vladkorotnev/cd-player/sch/sub/keypad/keypad.step

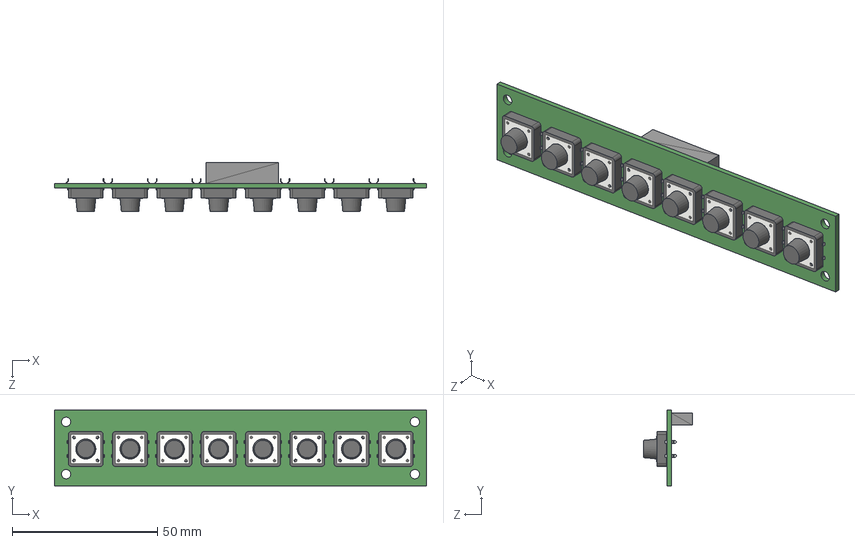
[picture p2: CAD file, 2025-03-11]
sch/sub/keypad/keypad.step
128.0 x 26.0 x 16.7 mm
Board_keypad
12mm_x_12mm_Tactile_switch_Button x 8
09DB-6S(LF)
