vladkorotnev/cd-player/(threads)

Thread 2 (2025-03-13):

Schematic image?

nuxeh, 2025-03-13:
Hi, this is wonderful. But I was thinking that maybe it would be nice for there to be an image showing the schematic in this repo somewhere, for documentation purposes, to get a quick idea of the overview, without having to have the correct EDA software available. Thanks!

vladkorotnev, 2025-03-14:
Good call, I've added [a PDF](https://github.com/vladkorotnev/cd-player/blob/master/sch/sch.pdf)

Be wary of the [errata](https://github.com/vladkorotnev/cd-player/blob/master/sch/errata.md) before putting anything together according to the schematic. For now it's fixed on my "local" PCBs with bodge wires :P

Closed 2025-03-14.

Thread 3 (2025-04-11):

Webradio ESP32

Raima010, 2025-04-11:
Hi Vlad. Its is not actually an issue but questions about your Cd  player project. You have modified a little bit Pschatzmann´s code which has some issues with internet radio stream buffering and got better results as I understood.
My question is would it be difficult to integrade just your web radio part in a simple Arduino ide sketch as example to test the perforrmance.  You use quite deep intergration with the rest of your project so its a little bit tricky to extract only what is needed? Can you give some tips on that or eventually down strip code limited just to Web radio-bluetooth receiver?
Simple arduino sketch for webradio which is given by Pschatzmann looks like this:

#include "Arduino.h"
#include "WiFi.h"
#include "Audio.h"
// Connections ESP32 <-> Amplifier
#define I2S_DOUT  2
#define I2S_BCLK  3
#define I2S_LRC   4
Audio audio;
// Wifi Credentials
String ssid =    "YOUR NETWORK";
String password = "YOUR PASSWORD";

void setup() {

  Serial.begin(115200);
  WiFi.disconnect();
  WiFi.mode(WIFI_STA);
  WiFi.begin(ssid.c_str(), password.c_str());
  while (WiFi.status() != WL_CONNECTED) {
    delay(500);
    Serial.print(".");
  }

  audio.setPinout(I2S_BCLK, I2S_LRC, I2S_DOUT);
  // Volume (0-100)
  audio.setVolume(10);
  // Radio stream, e.g. Byte.fm
  audio.connecttohost("http://www.byte.fm/stream/bytefm.m3u");

}

void loop()

{
  audio.loop();

}

We take in consideration that one would use ESP32 module with PSRAM.

Thank you for your comments.

vladkorotnev, 2025-04-11:
The whole radio pipeline is basically located in a [separate file](https://github.com/vladkorotnev/cd-player/blob/master/firm/src/mode/netradio/pipeline.h), where the AudioRouter's IOPortNub is your I2SStream in the simplest case. (I plan to potentially add other output routes someday later, so I obtain the output port from the router)

So in the simplest case you would just take that class, change the argument to accept an I2SStream instead of the AudioRouter, then instantiate it and call something like `pipeline.start("www.example.com/radio.mp3", [](bool loading) { if(loading) Serial.println("NOW LOADING!"); });` and there it goes!

I have to note that if you are not buying your ESP modules from a verified source such as Digikey (I was buying off some seller on Taobao), your mileage may vary. I was getting vastly different reliability among ESPs even in the same batch, although none of them worked with Phil's code at all.

Increasing the Net Buffer to e.g. 2KB makes things more stable, but with some lower bitrate radios it takes a very long while for the buffer to fill up.

One good idea would be to make an automatic buffer increase algorithm so that e.g. originally it only buffers to the 10% mark, upon stutter now it uses 20%, and so on... (please do a PR if you implement this :-)

Be that as it may, this is my daily driver radio now and it works more stable than any other projects I've tried so far (KaRadio and Phil's examples) — but then again, maybe my ESPs or internet are just bad.

Raima010, 2025-04-13:
Well, I made a try, but can not get it working..
Modified class to accept I2S stream:

class StreamingPipeline {
    public:
        StreamingPipeline(I2SStream *i2sStream):
            bufferNetData(NET_DATA_BUFFER_SIZE),
            bufferPcmData(PCM_DATA_BUFFER_SIZE, 1, portMAX_DELAY, portMAX_DELAY, fastAlloc),
            queueNetData(bufferNetData),
            queuePcmData(bufferPcmData),
            activeCodec(nullptr),
            decoder(&queueNetData, activeCodec),
            copierDownloading(queueNetData, urlStream),
            sndTask("IRASND", 8192, 8, 0),
            codecTask("IRADEC", 40000, 6, 1),
            netTask("IRANET", 20000, 14, 1),
            copierDecoding(decoder, queueNetData),
            copierPlaying(*i2sStream, queuePcmData) {
                outPort = i2sStream;
                semaSnd = xSemaphoreCreateBinary();
                semaNet = xSemaphoreCreateBinary();
                semaCodec = xSemaphoreCreateBinary();
                xSemaphoreGive(semaSnd);
                xSemaphoreGive(semaNet);
                xSemaphoreGive(semaCodec);
        }
....
protected:
        AudioStream * outPort;
        //AudioOutput* outPort;

******************************Arduino IDE sketch
#include "AudioTools.h"
#include "pipeline.h"
#include <WiFi.h>

Static I2SStream i2s;

#define I2S_BCLK   26
#define I2S_LRCLK  25
#define I2S_DOUT   22

void setup() {
  Serial.begin(115200);

  I2SConfig config;
  config.sample_rate = 44100;
  config.bits_per_sample = 16;
  config.channels = 1;
  config.pin_bck = I2S_BCLK;
  config.pin_ws = I2S_LRCLK;
  config.pin_data = I2S_DOUT;

  // Initialize I2S and Pipeline
  i2s.begin(config);
  pipeline.start("http://stream.radioparadise.com/mp3-192", [](bool loading) { if(loading) Serial.println("NOW LOADING!"); });
}

void loop() {
   delay(1000);
}
*********************************************************

It compiles, but silently crashes in urlStream.begin(url.c_str());. On the URLStream.h side on "if (!preProcess(urlStr, acceptMime))" where acceptMime gets null pointer. Hardcoding this doesnt help either.

Any Ideas? Or what I am missing here?

vladkorotnev, 2025-04-13:
Please use the code formatting (put ``` on the lines before and after) when pasting code, it's very hard to read otherwise

If anything, I cannot find where is your `pipeline` variable initialized, neither the code that does the WiFi connection and then waits for it to complete (it was there in your original post but not the new one). So maybe the ESP is just not connected to the WiFi which triggers some bug in AudioTools.

Raima010, 2025-04-14:
Sorry I took too much line to be it more readable but it may take in confution. Here is 100% sketch:

put``

#include "AudioTools.h"
#include "pipeline.h"
#include <WiFi.h>

const char* ssid = "mySSID";
const char* pasword = "myPassword";

static I2SStream i2s;

#define I2S_BCLK   26
#define I2S_LRCLK  25
#define I2S_DOUT   22

void setup() {
  Serial.begin(115200);

   WiFi.mode(WIFI_STA); //Optional
   WiFi.begin(ssid, pasword);
   Serial.println("\nConnecting");
    while(WiFi.status() != WL_CONNECTED){Serial.print(".");delay(100);}                             
    Serial.println("\nConnected to the WiFi network");
    Serial.print("Local ESP32 IP: ");
    Serial.println(WiFi.localIP());

  // Config object for I2SStream
  I2SConfig config;
  config.sample_rate = 44100;
  config.bits_per_sample = 16;
  config.channels = 1;
  config.pin_bck = I2S_BCLK;
  config.pin_ws = I2S_LRCLK;
  config.pin_data = I2S_DOUT;

  // Initialize I2S and Pipeline
  i2s.begin(config);
  StreamingPipeline pipeline(&i2s);
  pipeline.start("http://stream.radioparadise.com/mp3-192", [](bool loading) { if(loading) Serial.println("NOW LOADING!"); });
}

void loop() {
   delay(1000);

}  ``

So we get on Serial that wifi is connected. Get into pipeline.h code, and rigt in the function url.begin(url.c_str() it hangs. There it calls URLStream.h from audiotools and stops with preprocessor with acceptMime nullptr. No more output on Serial, no ESP WDT reboot, nothing more. Wondering if can be some memory issues, core issues or still error in code..
Hardware on I2S with simple sine generator code tested and working.

vladkorotnev, 2025-04-14:
You are declaring the StreamingPipeline variable inside of the setup method. So when the `pipeline.start()` method returns, the setup method ends, and the pipeline variable is deleted, releasing all underlying resources. However the threads started by the pipeline still live on, so if you're lucky you get a crash with a stack trace, otherwise the ESP continues to execute some random place in memory or hangs waiting on some semaphore/spinlock.

Make the pipeline variable static and put it outside of the setup method (e.g. right on the next line after your I2SStream) and it should behave correctly

Closed 2025-04-14.
