vladkorotnev/cd-player/sch/sch.pdf

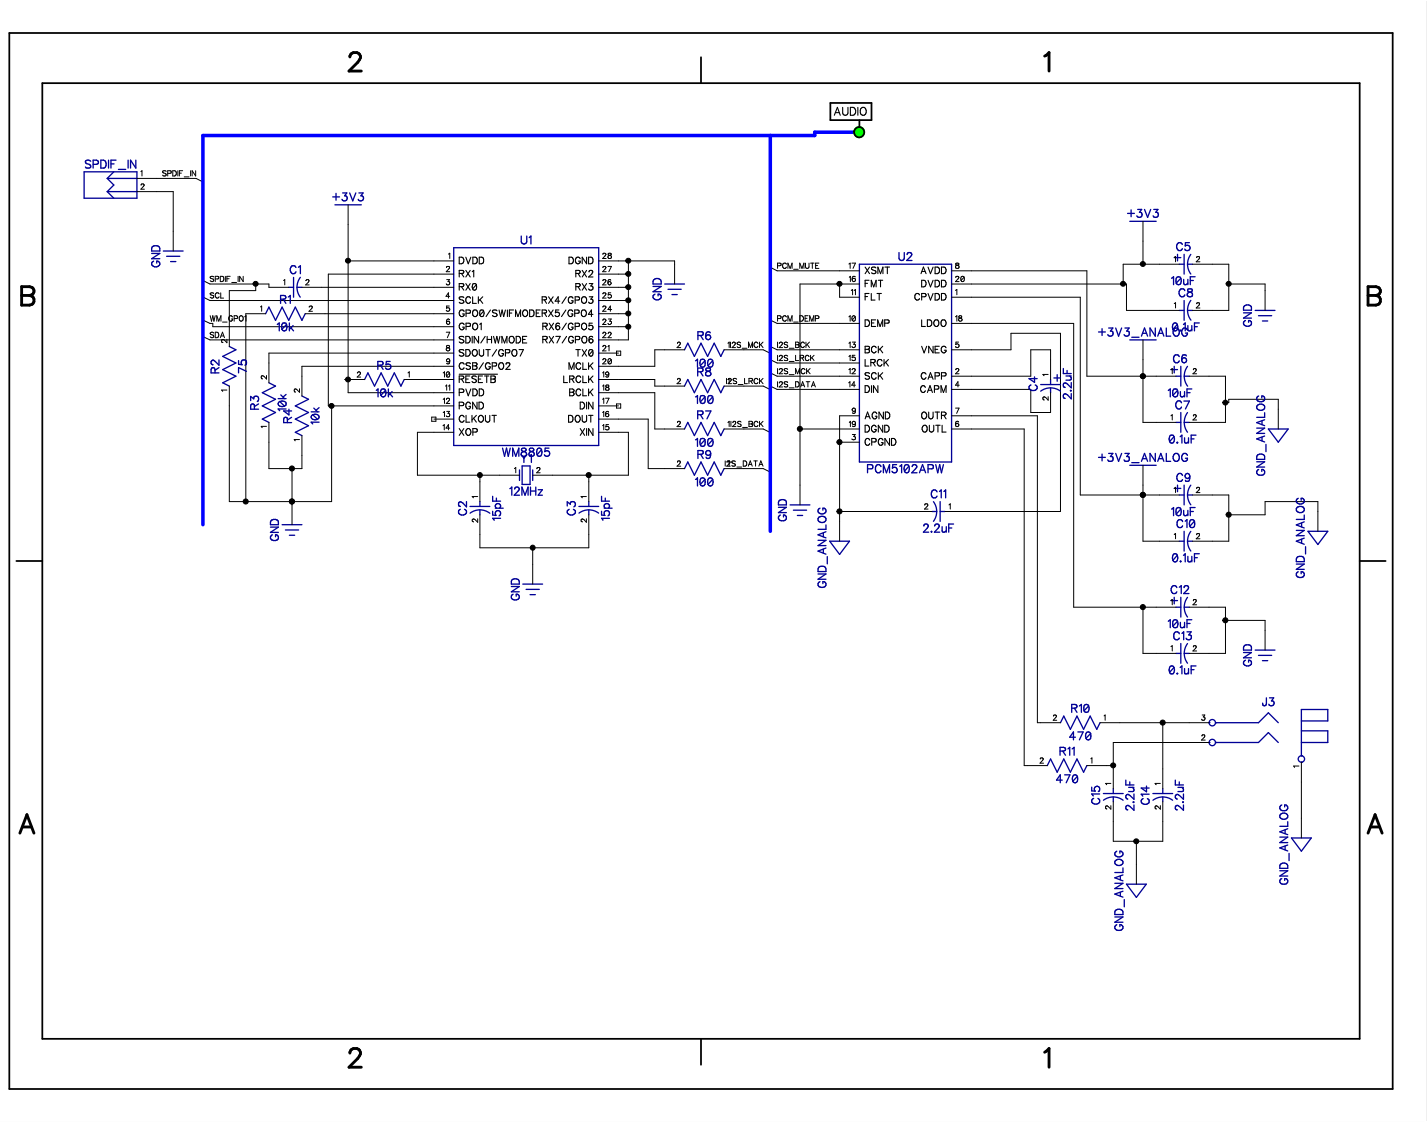
[picture p3: page 1]

DGND 19 | 6

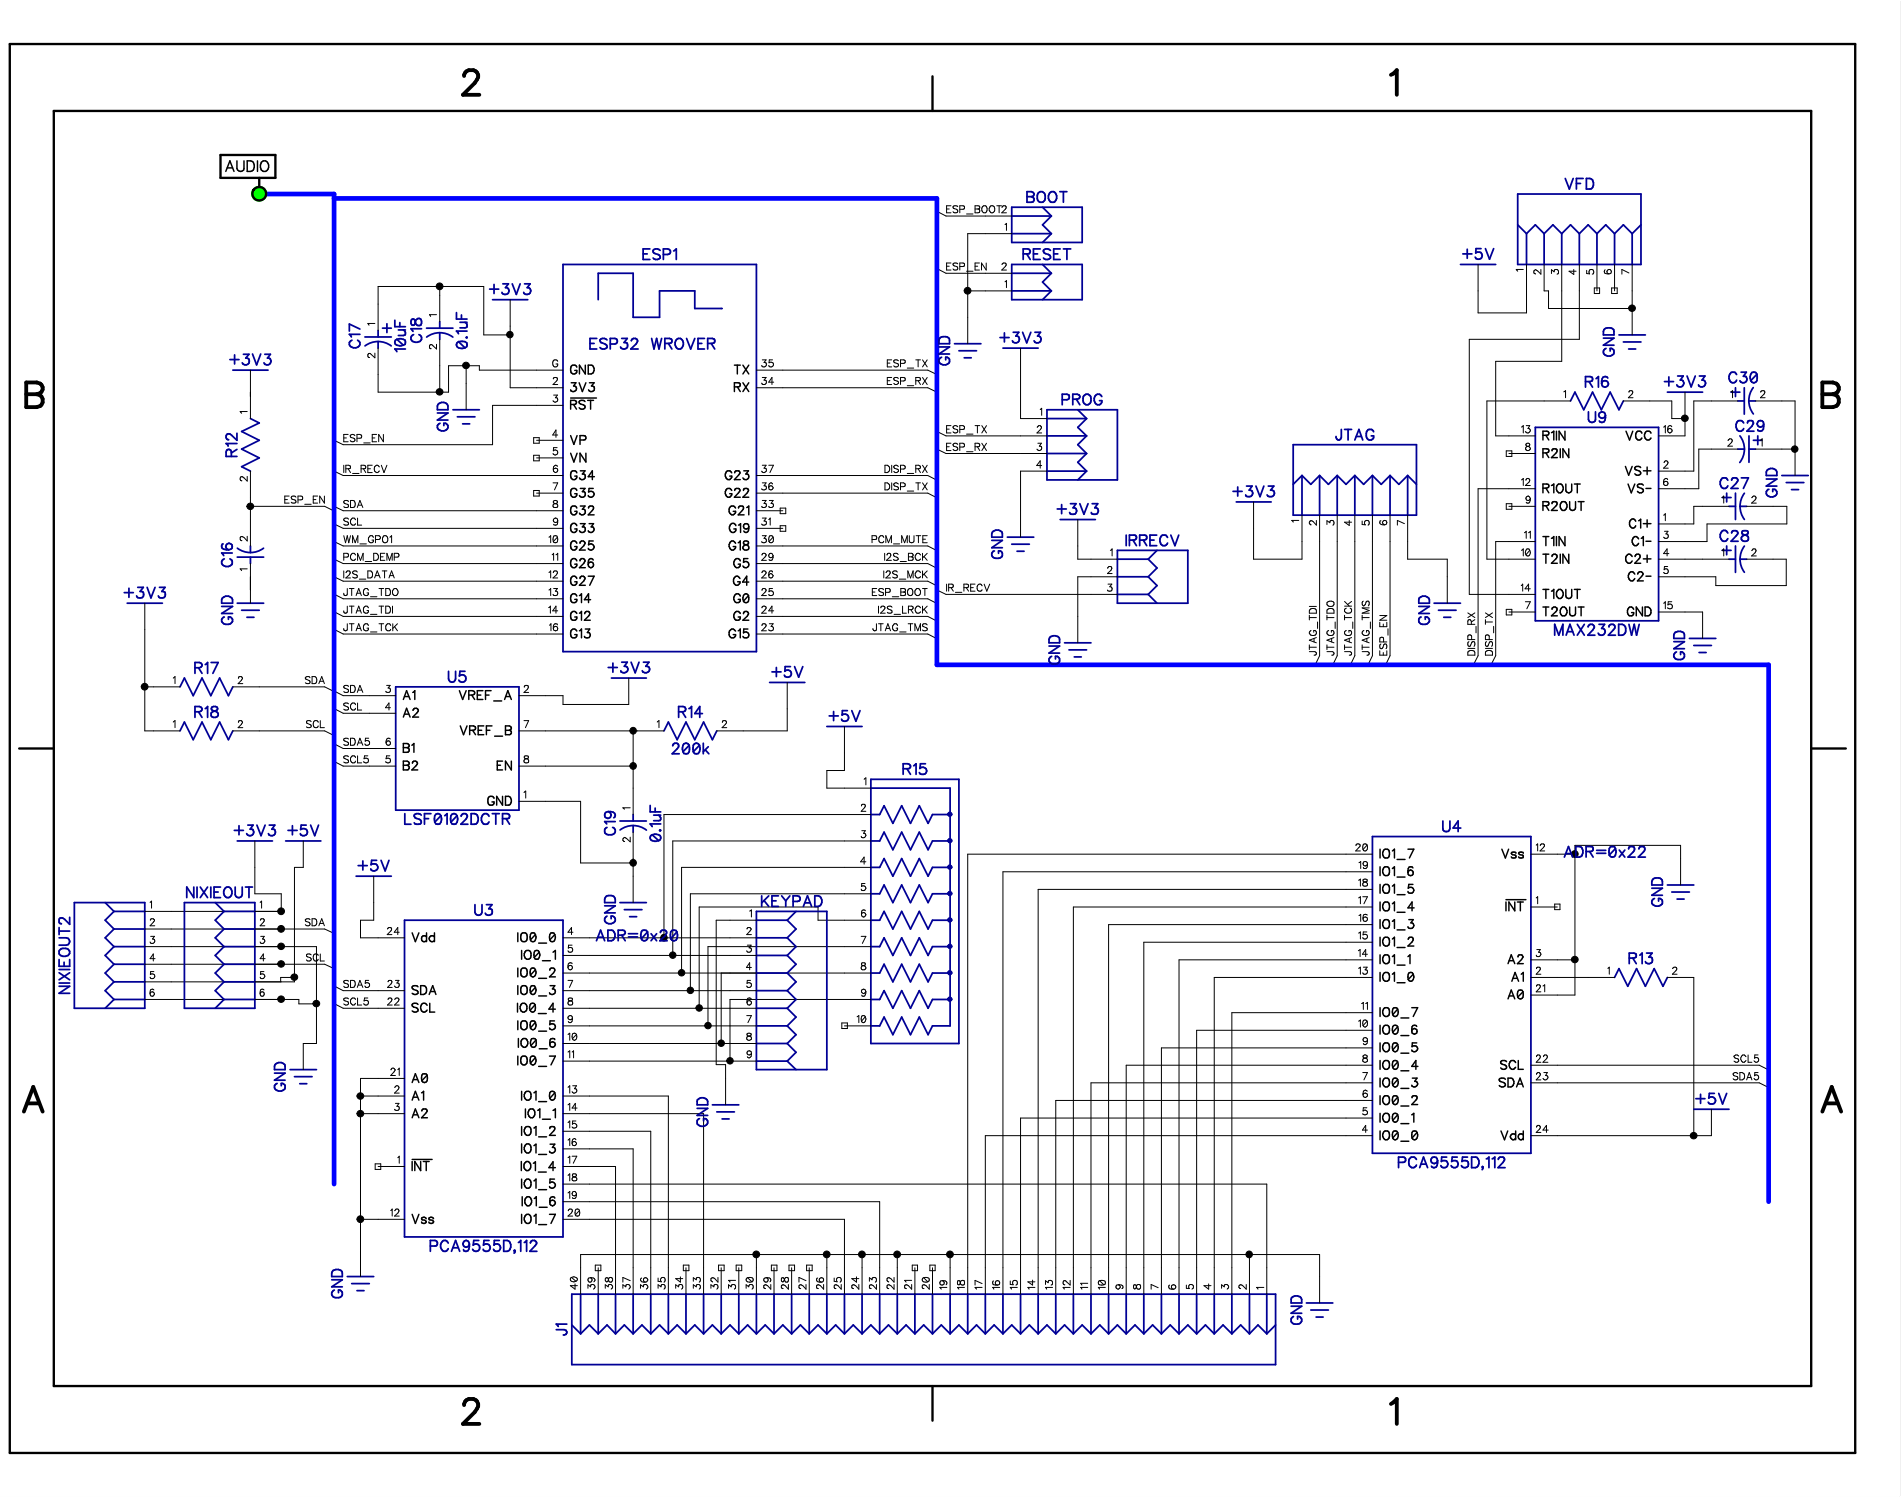
[picture p4: page 2]

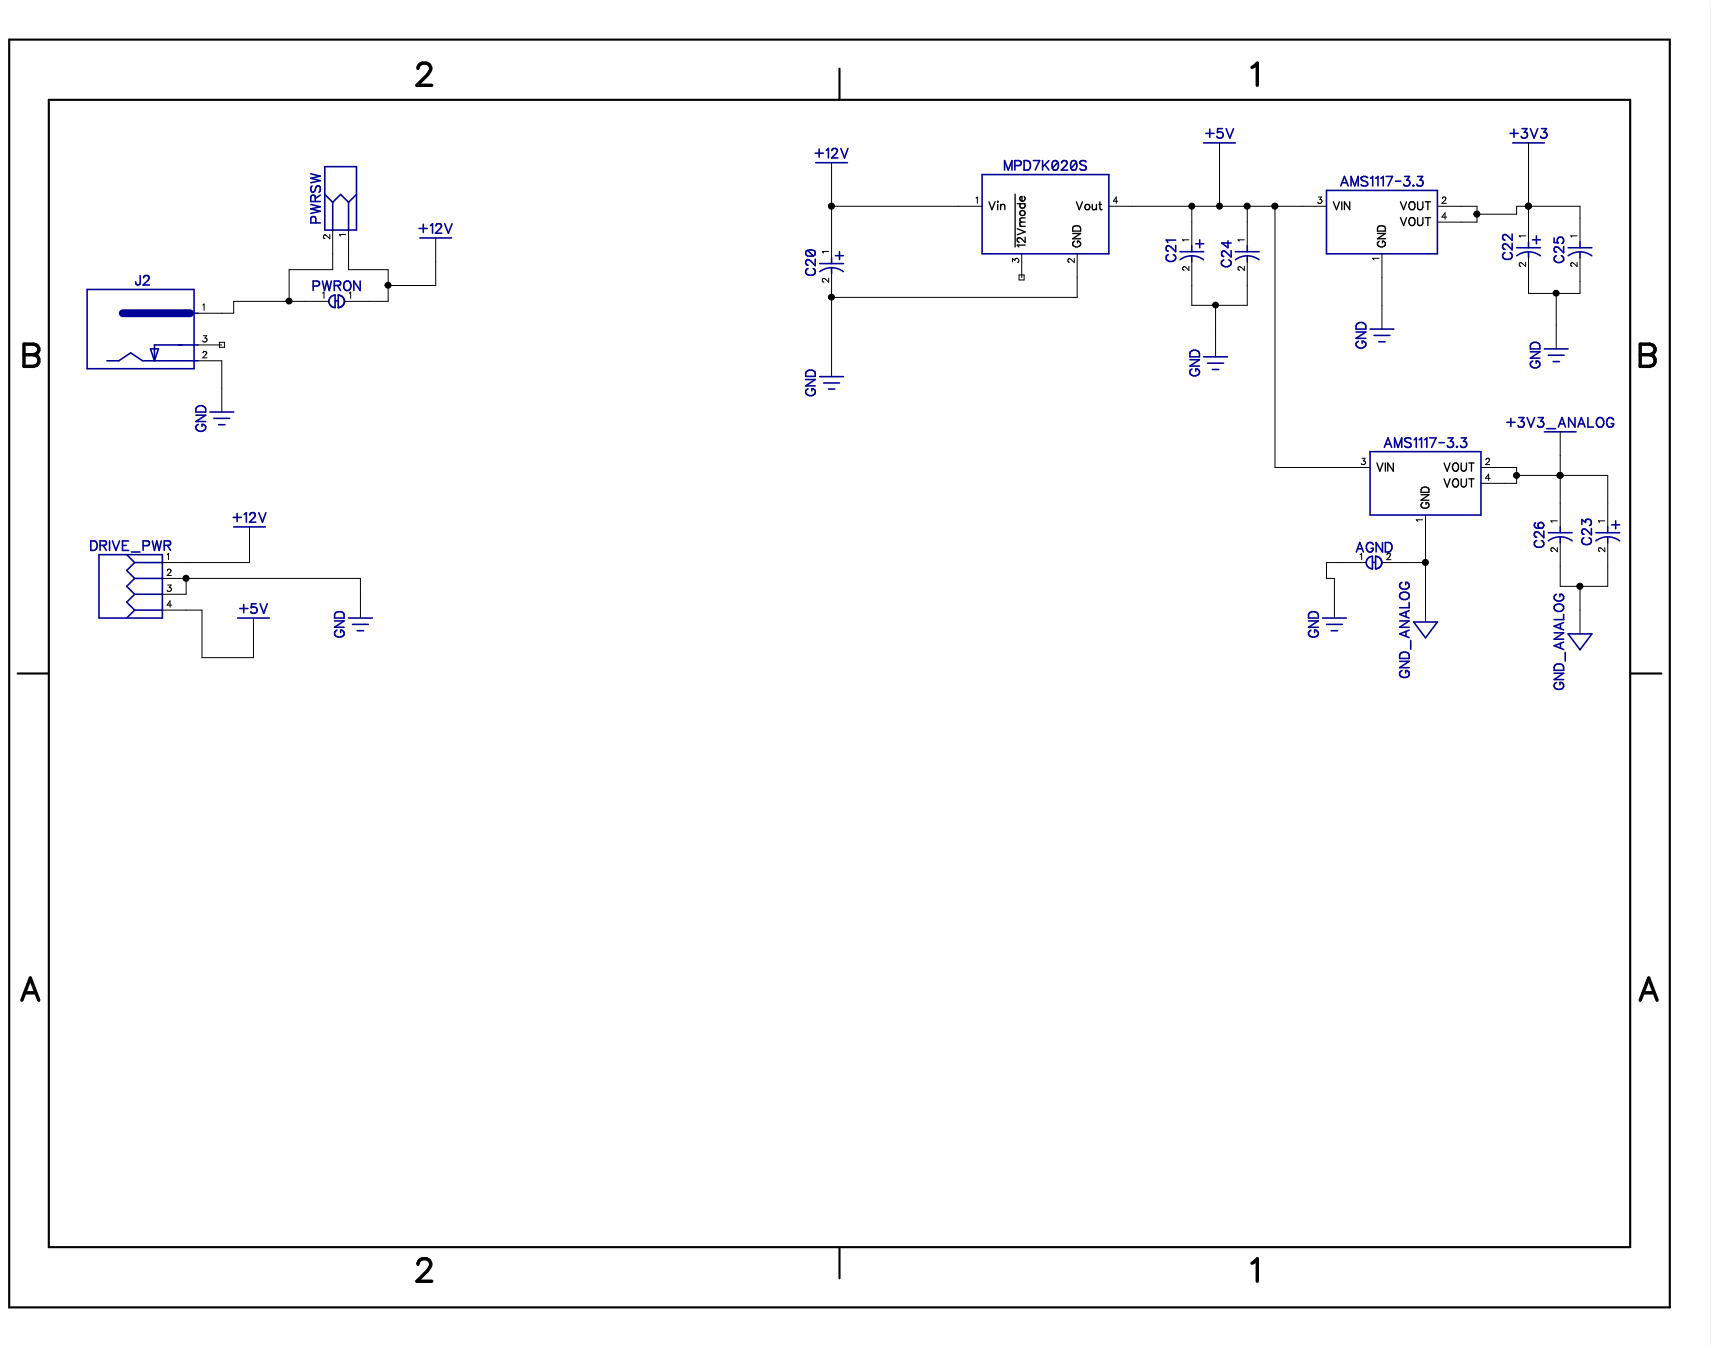
[picture p5: page 3]
