vladkorotnev/cd-player/sch/sub/keypad/keypad.pdf

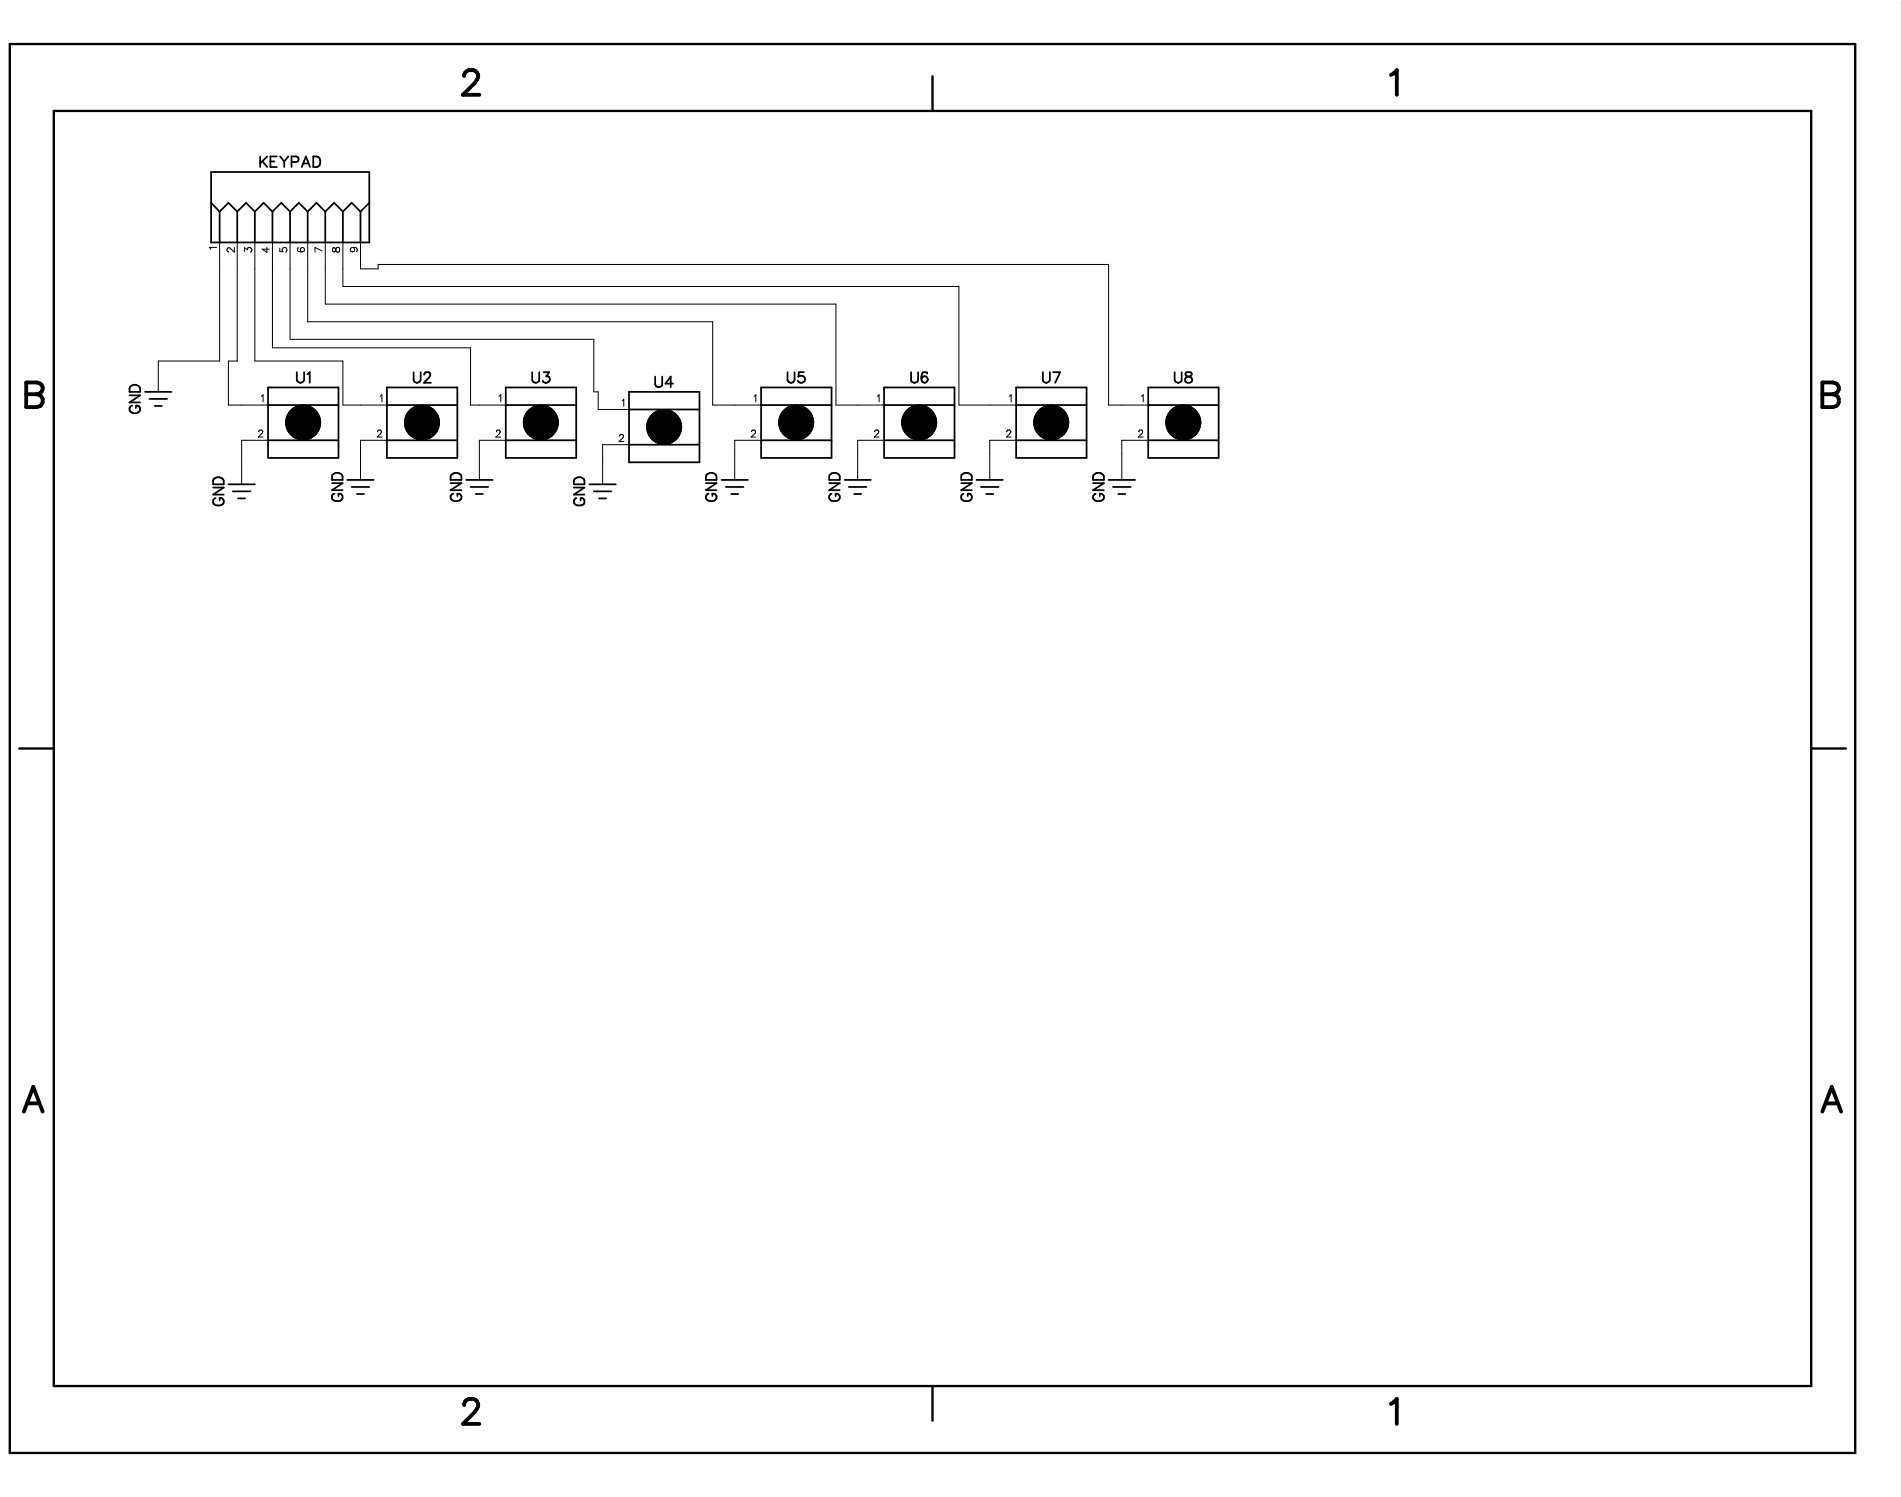
[picture p6: page 1]
