vladkorotnev/cd-player/(list of files, drawings)

Other design files:
sch/cdp.dip
sch/sch.dch
sch/sub/keypad/keypad.dch
sch/sub/keypad/keypad.dip
