vladkorotnev/cd-player/firm/src/localize.cpp

#include <localize.h>
#include <esp_attr.h>
#include <map>
#include <esper-core/prefs.h>
#include <ArduinoJson.h>
#include <LittleFS.h>
#include <shared_prefs.h>

#ifndef LANG_DIR_PREFIX
#define LANG_DIR_PREFIX "/lang"
#endif

static const char LOG_TAG[] = "LOCA";

DisplayLanguage active_language() {
    return (DisplayLanguage) Prefs::get(PREFS_KEY_UI_LANGUAGE);
}

void set_active_language(DisplayLanguage lang) {
    Prefs::set(PREFS_KEY_UI_LANGUAGE, (int)lang);
}

const std::string language_name(DisplayLanguage lang) {
    switch(lang) {
        case DSPL_LANG_RU: return "Русский";
        case DSPL_LANG_JA: return "日本語";
        case DSPL_LANG_EN: return "English";
        default:
            return "???";
    }
}

static DisplayLanguage lang_map_language = DSPL_LANG_INVALID;
static EXT_RAM_ATTR std::map<const std::string, std::string> lang_map = {};

static bool _load_lang_map_if_needed() {
    DisplayLanguage lang =  active_language();
    if(lang_map_language == lang) return true;

    lang_map.clear(); // otherwise switching to "implicit"/native locale fails

    const char * filename = nullptr;
    switch(lang) {
        case DSPL_LANG_RU:
            filename = LANG_DIR_PREFIX "/ru.lang";
            break;
        case DSPL_LANG_JA:
            filename = LANG_DIR_PREFIX "/ja.lang";
            break;
        case DSPL_LANG_EN:
        default:
            filename = LANG_DIR_PREFIX "/en.lang";
            break;
    }

    File f = LittleFS.open(filename, "r");
    if(!f) {
        ESP_LOGE(LOG_TAG, "Loading %s failed! No such file? Pretending nothing happened.", filename);
        lang_map_language = lang;
        return false;
    }

    JsonDocument content;
    DeserializationError error = deserializeJson(content, f);
    if(error) {
        ESP_LOGE(LOG_TAG, "Parsing %s failed: %s", filename, error.c_str());
        lang_map_language = lang;
        return false;
    }

    JsonObject root = content.as<JsonObject>();
    int i = 0;

    for (JsonPair kv : root) {
        std::string val = kv.value().as<std::string>();
        lang_map[kv.key().c_str()] = val;
        i++;
    }

    lang_map_language = lang;
    ESP_LOGI(LOG_TAG, "Loaded language ID=%i, Entries: %i", lang_map_language, i);
    return true;
}

const std::string localized_string(const std::string& key) {
    if(!_load_lang_map_if_needed()) ESP_LOGW(LOG_TAG, "Failed to load map when translating [%s]", key.c_str());

    if(lang_map.count(key)) {
        return lang_map.at(key);
    } else {
        return key;
    }
}
