vladkorotnev/cd-player/firm/include/platform.h

#pragma once
#include <esper-core/platform.h>
#include <esper-cdp/atapi.h>
#include <esper-gui/compositing.h>

/// @brief Contains the resources shared across modes
struct PlatformSharedResources {
    Core::ThreadSafeI2C * i2c;
    Platform::Keypad * keypad;
    Platform::Remote * remote;
    Platform::AudioRouter * router;
    Graphics::Hardware::DisplayDriver * display;
    Platform::IDEBus * ide;
    ATAPI::Device * cdrom;
};

const EGSize DISPLAY_SIZE = {160, 32};
