vladkorotnev/cd-player/(commit log)

2024-12-14 schematic wip
    [sch.dch]
2025-01-16 IN12 Nixie Display Module
    [nixierator.dch, nixierator.dip]
2025-01-16 wip (use RS232 for the display in the end)
    [cdp.dip, sch.dch]
2025-01-17 [wip] all PCBs pass connectivity tests and DRC
    [cdp.dip, keypad.dch, keypad.dip, nixierator.dip, sch.dch]
2025-01-21 wip jlc order
    [cdp.dip, nixierator.dip]
2025-01-27 Errata of received PCBs, Nixierator rev2
    [nixierator.dch, nixierator.dip, nixieratorV1.dch, nixieratorV1.dip]
2025-01-27 i2c expander address correction
    [sch.dch]
2025-01-28 Create barebones firmware
    [partitions.csv]
2025-01-28 This seems to communicate with the drive just fine!
    [partitions.csv]
2025-01-29 fix endianness bug; changer control seems to work
    [main.cpp]
2025-02-02 Tentative WM8805 driver for when it arrives finally
2025-02-11 display test
    [partitions.csv]
2025-02-15 start building up arch of various modes
    [nixierator.dch]
2025-02-18 Lyrics display works but no word wrap; fix not byte-aligned blitting; add k8x12 font
    [lyric_player.h, main.cpp, mode.h]
2025-02-19 working caching and small fixes here and there
    [main.cpp, mode.h]
2025-02-21 doc updates, fixes of UI stuff, shuffle mode, WiFi service module
    [main.cpp]
2025-02-21 data track related polish
2025-02-22 bump i2c freq and readme, fix layout bug when shuffle
    [main.cpp]
2025-02-26 laggy but async playing, relax-fm also not buggy
    [main.cpp]
2025-02-27 Fix cddb ll definition conflict with ESP32 bt stack
2025-03-01 mode switching
2025-03-01 Well, it builds with all modes in the firmware now...
    [nixierator.dip]
2025-03-03 Remote control support; minor fixes; no crashes when switching net radio stations
    [main.cpp, mode.h, mode_host.h]
2025-03-03 Prefs framework and kind of a boot screen
2025-03-04 Add a boot screen and standby mode (actual power consumption TBD)
2025-03-07 Make threaded scrobbler actually do its job
2025-03-10 Lock the tray when in standby
    [cdp.step, keypad.step]
2025-03-10 OTA flashing
    [cdp.dip, keypad.dip, keypad.step]
2025-03-14 Schematic pdfs (#2)
    [nixierator.dch, nixierator.dip, nixieratorV1.dch, nixieratorV1.dip, sch.dch]
2025-03-20 Add passthrough relay on pin 19
2025-03-21 Allow recovering out of some less fatal conditions via OTA without opening the case
2025-03-21 digit key on remote now plays the track by the number
2025-03-26 Support entering track number from remote
2025-03-27 Fix draw_rect and add frame around lyrics
2025-04-24 Don't leave lyrics hanging for a while if current track had a last line but the next track has none
2025-05-29 Somewhat ass but kinda working workaround for settings menu stack overflow...
    [framework.h, main.cpp, shared_prefs.h]
2026-10-31 serve remote from the device itself
2026-10-31 pin platform version
2026-10-31 hotfix wrong display uart
